accemic/TraceEncoder/TRADEMARKS.md

<!--
SPDX-FileCopyrightText: 2026 Accemic Technologies GmbH
SPDX-License-Identifier: CC-BY-4.0
-->

# Trademarks

**CEDARtools** is a registered trademark of Accemic Technologies GmbH.
Its use in this project's name (CEDARtools.TraceEncoder) and
documentation identifies the project's origin; it does not grant any
trademark rights beyond what the licenses in [`LICENSE.md`](LICENSE.md)
state.

**The Accemic logo shipped with the dashboard**
(`examples/dashboard/logo_acctech.svg`) carries a trade-mark permission of
its own,
[`LICENSES/LicenseRef-Accemic-Trademark.txt`](LICENSES/LicenseRef-Accemic-Trademark.txt):
reproduce it unaltered to identify Accemic products, do not modify it, do not
use it as a badge of origin for anything else. It was previously offered
under CC-BY-4.0, which expressly permits adaptations -- of a mark, which is
the one thing that must not be adapted, and which this page relies on not
being adapted. Corrected 2026-08-19. Nothing else in the repository changed:
a mark is never part of an open-source grant, and separating the two is what
projects with a name worth protecting do.

This project implements and references several open specifications and
interoperates with third-party tools. Third-party marks appear here **only
descriptively**, to identify those specifications, interfaces and tools
(nominative use). Their use does **not** imply any affiliation with,
sponsorship by, or endorsement by the trademark owners.

## Attribution

CEDARtools and Accemic are trademarks of the Accemic Technologies GmbH.

RISC-V, RISC-V International, and the RISC-V logos are trademarks of RISC-V
International.

MicroBlaze, Vivado, Xilinx and Kria are trademarks of Advanced Micro Devices,
Inc.

Arm, AMBA, AXI, ATB and CoreSight are trademarks or registered trademarks of
Arm Limited (or its affiliates).

Nexus and IEEE-ISTO 5001 are marks of the IEEE Industry Standards and
Technology Organization (IEEE-ISTO) / Nexus 5001 Forum.

IAR and IAR Systems are trademarks of IAR Systems AB.

All other product names, logos, and brands are the property of their
respective owners and are used in this document for identification purposes
only; such use does not imply affiliation with, sponsorship by, or endorsement
from their respective owners.

## Use of the RISC-V mark

Accemic Technologies GmbH is **not** a member of RISC-V International. The
mark therefore appears in this repository **only** in its descriptive sense —
naming the architecture and the specifications this encoder targets, as in
*"trace encoder for RISC-V cores"* or *"implements the RISC-V N-Trace
specification"*.

Specifically, this repository does not and must not:

- use the RISC-V logo;
- use "RISC-V" as part of the product, module or domain name — the product is
  **CEDARtools.TraceEncoder**, and RISC-V only describes what it targets;
- claim membership, partnership, certification, approval or endorsement;
- claim conformance or compatibility certified by any official RISC-V
  programme. Deviations from the specifications are listed openly in
  [`doc/trace-format.adoc`](doc/trace-format.adoc), and the vendor TCODEs
  56/57/58 are Accemic extensions that imply no claim of standard conformance.

"RISC-V" is written in block letters with a hyphen; the only admissible
spellings are *RISC-V* and *RISC-V International*.
