accemic/TraceEncoder/MAINTAINERS.md

<!--
SPDX-FileCopyrightText: 2026 Accemic Technologies GmbH
SPDX-License-Identifier: CC-BY-4.0
-->

# Maintainers

This file lists the people who maintain CEDARtools.TraceEncoder (CTTE).
Maintainers have
write access, review and merge PRs, and steer the project's
direction. For machine-readable review routing, see
[`.github/CODEOWNERS`](.github/CODEOWNERS).

## Active maintainers

| Name | GitHub | Contact | Focus |
|---|---|---|---|
| Albert Schulz | [@albertschulz](https://github.com/albertschulz) | <aschulz@accemic.com> | Architecture, RTL, RDL |
| Alexander Weiss  | [@accemic-weiss](https://github.com/accemic-weiss) | <aweiss@accemic.com> | Encoder core, verification, tooling |

## Becoming a maintainer

The maintainer set will grow as the
open-source contributor base does. Sustained, high-quality
contributions (RTL, verification, documentation) and demonstrated good
judgement on reviews are the path in. Reach out to an active
maintainer if you'd like to take on more responsibility.

## Contact

- General inquiries: <info@accemic.com>
- Security disclosures: <info@accemic.com>
- Commercial licensing: <sales@accemic.com>
