accemic/TraceEncoder/(commit log)

2026-07-27 Rename the project from C-Trace to CEDARtools.TraceEncoder.
2026-07-28 Point repository URLs at the renamed accemic/TraceEncoder.
2026-08-04 Add the TGC5B example SoC with simulation and KV260 board flows.
    A self-contained system that drives the encoder from a real RISC-V core
    instead of the synthetic cpu_model stimulus used by the unit tests: the
    MINRES TGC5B (RV32I) core plus RAM, CLINT and INTC, with ct_tip_adapter
    mapping the core's flat H2E trace port onto the encoder's tip_if. Three
    nested tops — the bare SoC (ct_soc_synth_wrap), the AXI4-Lite control port
    around it (ct_soc_top), and the KV260 bitstream top.
    - Simulation: sim.sh traces an arbitrary ELF; `make sim-tgc5b-soc` runs the
    committed hello_trace program and checks the trace decodes with NexRv,
    `make sim-tgc5b-ps` exercises the same SoC through the devmem flo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
2026-08-28 Release 1.0.0: CEDARtools.TraceEncoder as a publishable repository
    The RTL is the one every verdict below was measured against; what
    changed since the initial public tree is that the repository became
    publishable and complete:
    - Two back ends, one event stream: N-Trace (Nexus messages on ATB)
    and E-Trace 2.0 (te_inst packets), selected per instance by
    synthesis parameter, with the enhanced features (DAQ / ACT-CAP,
    filtering, sync variants, funnel, watchpoint records, DDR rings).
    - Ingress adapters for AMD MicroBlaze V, CVA6 ITI and Rocket TCI,
    and the MINRES TGC5B example SoC library.
    - Nine KV260 demonstrators plus the RV/CFI demo, each with its
    ready-to-load prebuilt app in-tree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
    [families.tsv, itype_decoder_vectors.csv, sites_core0.csv, sites_core1.csv]
