accemic/TraceEncoder/(notices)

Notices in the files:
README.md:
License: CERN-OHL-S-2.0 OR Accemic-Commercial
